dhruvparmar33311-sketch/Room-Scanning-using-60hz-sensor/radar scanner top view image.jpeg

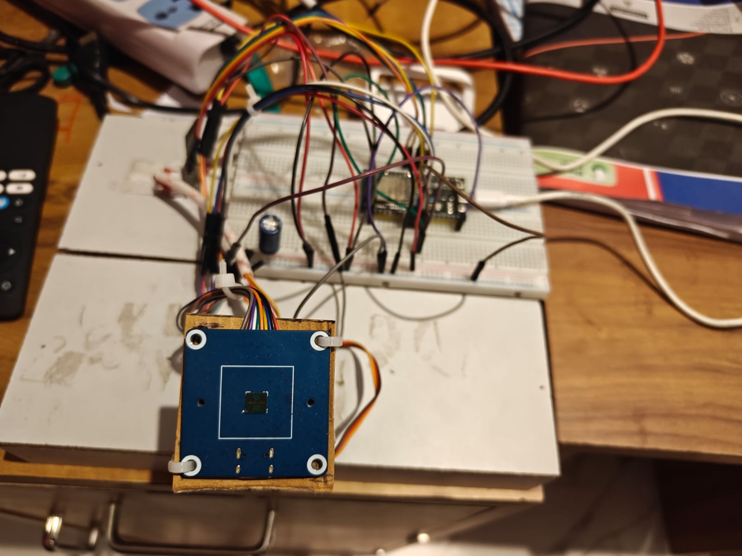
radar scanner top view image.jpeg
