dhruvparmar33311-sketch/Room-Scanning-using-60hz-sensor/radar scanner side view image.jpg

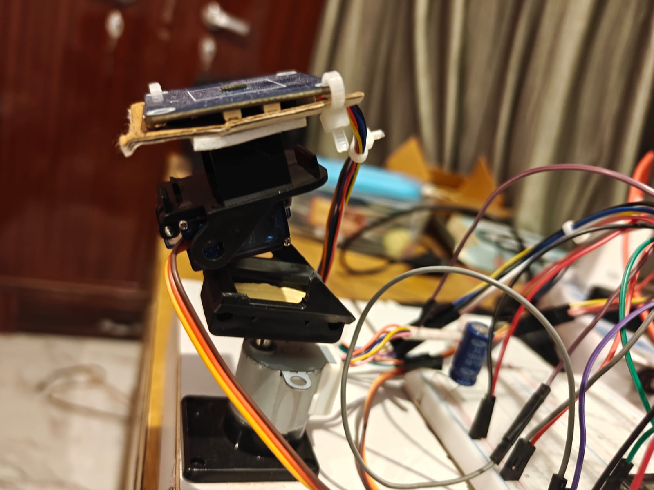
radar scanner side view image.jpg
