dhruvparmar33311-sketch/Room-Scanning-using-60hz-sensor/important_note.txt

All of the coordinate output generated by the whole model is transmitted to COM 10 port only so make sure you select the COM 10 port in your Device manager for your ESP32 board.
