dhruvparmar33311-sketch/Room-Scanning-using-60hz-sensor/output3d file.png

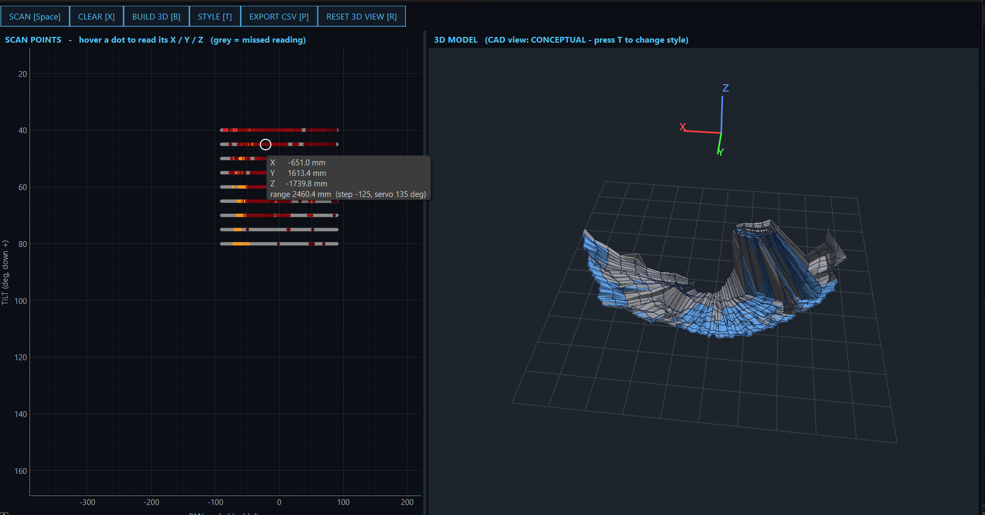
output3d file.png
